astrutz/PPSS18Strutz/Dokumente/Bachelorarbeit/chapter/titelseite.tex

%!TEX root = ../main.tex
\begin{titlepage}

\begin{center}

% Logo der Technische Hochschule Köln
\begin{figure}[!ht]
%	\centering
%		\includegraphics[width=0.26\textwidth]{/images/THlogoheader.pdf}
\end{figure}

\vspace{0.4cm}

%Deutscher Titel
\begin{rmfamily}
\begin{huge}
\textbf{Nutzerzentrierte Entwicklung eines Systems zur Synchronisation von analogen und digitalen Scrumboards}\\	
\end{huge}
\vspace{0.5cm}
%\begin{LARGE}
%ggf. Untertitel\\
%\end{LARGE}
\end{rmfamily}

\vspace{0.8cm}

%Englischer Titel
% \begin{rmfamily}
% \textbf{\LARGE Title in English}\\
% \large with a very\\long subtitle\\
% \normalsize
% \end{rmfamily}

% \vspace{1.2cm}

%Bachelorarbeit 
\begin{LARGE}
\begin{scshape}
Bachelorarbeit\\[0.8em]
\end{scshape}
\end{LARGE}

%ausgearbeitet von...
\begin{large}
ausgearbeitet von\\ 
\vspace{0.3cm}
\begin{LARGE}
Alexander Strutz\\
\end{LARGE}
\end{large}

\vspace{1.2cm}

%zur Erlangung des akademischen Grades...
\begin{large}
zur Erlangung des akademischen Grades\\
\vspace{0.1cm}
\textsc{Bachelor of Science (B.Sc.)}\\ 
\end{large}

\vspace{0.6cm}

%vorgelegt an der...
\begin{large}
vorgelegt an der\\ 
\vspace{0.2cm}
\begin{scshape}
Technischen Hochschule Köln\\
Campus Gummersbach\\
Fakultät für Informatik und\\
Ingenieurwissenschaften\\
\end{scshape}
\end{large}

\vspace{0.6cm}

%im Studiengang...
\begin{large}
im Studiengang\\ 
\vspace{0.1cm}
\textsc{Medieninformatik}
\end{large}

\vspace{1.2cm}

%Autor der Bachelorarbeit und die Prüfer
\begin{tabular}{rl}
        Erster Prüfer:  &  Prof. Dr. Matthias Böhmer\\
       					&  \small Technische Hochschule Köln \\[1.0em]
       Zweiter Prüfer:  &  Oliver Blum\\
       					&  \small kernpunkt Digital GmbH\\
\end{tabular}

\vspace{1.2cm}

%Ort, Monat der Abgabe
\begin{large}
Gummersbach, im Dezember \the\year
\end{large}

\end{center}

\newpage
\thispagestyle{empty}

%Kontaktmöglichkeiten des Autors und der Prüfer
\begin{center}
\begin{tabular}{rl}
							&  \\[26.0em]
							
\large \textbf{Adressen:}	&  	\quad Alexander Gabriel Strutz\\
							&  	\quad Hohe Straße 28\\
							&	\quad 51643 Gummersbach\\
							&  	\quad astrutz@th-koeln.de\\[2.0em]
							
							&  	\quad Prof. Dr. Matthias Böhmer\\
							&  	\quad Technische Hochschule Köln\\
							&  	\quad Institut für Informatik\\
							&	\quad Steinmüllerallee 1\\
							&	\quad 51643 Gummersbach\\
							&  	\quad matthias.boehmer@th-koeln.de\\[2.0em]
							
							&  	\quad Oliver Blum\\
							&  	\quad kernpunkt Digital GmbH\\
							&	\quad Oskar-Jäger-Straße 173\\
							&	\quad 50825 Köln\\
							&  	\quad oliver.blum@kernpunkt.de\\[2.0em]
\end{tabular}
\end{center}

\end{titlepage}
