astrutz/PPSS18Strutz/Dokumente/Bachelorarbeit/chapter/eid.tex

%!TEX root = ../main.tex
\chapter*{Eidesstattliche Erklärung}

Ich versichere, die von mir vorgelegte Arbeit selbständig verfasst zu haben.\\ \\
Alle Stellen, die wörtlich oder sinngemäß aus veröffentlichten oder nicht veröffentlichten Arbeiten anderer entnommen sind, habe ich als entnommen kenntlich gemacht. Sämtliche Quellen und Hilfsmittel, die ich für die Arbeit benutzt habe, sind angegeben.\\ \\
Die Arbeit hat mit gleichem Inhalt bzw. in wesentlichen Teilen noch keiner anderen Prüfungsbehörde vorgelegen.
\vspace{1.5cm}
\\
Gummersbach, \today
\vspace{3cm}
\\
Alexander Gabriel Strutz
