astrutz/PPSS18Strutz/Dokumente/Bachelorarbeit/chapter/header.tex

%!TEX root = ../main.tex
%\documentclass[12pt]{article}
\documentclass[BCOR=12mm,DIV=11,titlepage,a4paper,oneside]{scrbook}
\usepackage{scrhack}
\usepackage[ngerman]{babel}
\usepackage[utf8x]{inputenc}
\usepackage{amsmath}
\usepackage{graphicx}
\usepackage{caption}
\usepackage[colorinlistoftodos]{todonotes}
\usepackage{subcaption}

%fancyheadings funktioniert nicht mehr mit der KOMA Script Klasse scrbook

\usepackage{wrapfig}

\usepackage{cite}

% Mittels [H] können Bilder genau an einer Stelle positioniert werden
\usepackage{float}

\usepackage[breaklinks]{hyperref}

% bewirkt das HyperLinks in der PDF nicht umrandet oder farbig sind
\hypersetup{colorlinks=false}

% package for colored text
% black,white,green,red,blue,yellow,cyan,magenta
\usepackage{color}

% package for colored tables
\usepackage{colortbl}

%Paket zur Erzeugung von Anführungszeichen durch \enquote{Text}
\usepackage[ngerman]{babel}
\usepackage[babel, german=quotes]{csquotes}

%Verhindern, dass eine neue Seite für ein einzelnes Wort/Zeile verwendet wird
\clubpenalty = 10000 % schliesst Schusterjungen aus 
\widowpenalty = 10000 % schliesst Hurenkinder aus (keine Beleidigung, sondern wirklich ein Fachbegriff)

\usepackage{lipsum}

\pagenumbering{gobble}
