astrutz/PPSS18Strutz/Dokumente/Bachelorarbeit/chapter/00_abstract.tex

%!TEX root = ../main.tex
\chapter*{Abstract}
\label{cha:Einleitung}
Hier folgt die Kurzfassung auf Englisch. Wenn Sie diese Vorlage für Seminararbeiten, Projektdokumentation o.ä. verwenden ist eine englische Kurzfassung ggf. nicht nötig.
