astrutz/PPSS18Strutz/Dokumente/Bachelorarbeit/chapter/03_durchfuehrung_und_vorgehensweise.tex

%!TEX root = ../main.tex
\chapter{Durchführung und Vorgehensweise}
\label{cha:durchfuehrung_und_vorgehensweise}

\section{Abweichungen vom menschzentrierten Entwicklungsprozess}
\label{sec:abweichungen_menschzentriert}
Fußnoten können zum Teil sehr nützlich sein. Bitte beachten Sie, dass bei übermäßiger Verwendung von Fußnoten, die Lesbarkeit einschränkt sein.

\section{Festlegung der Anzahl an Teams und Phasen}
\label{sub:festlegung_anzahl_teams_phase}
Sie können in Latex viel machen.

\section{Formulierung einer Forschungsfrage}
\label{sub:formulierung_forschungsfrage}
Sie können in Latex viel machen.
