astrutz/PPSS18Strutz/Dokumente/Bachelorarbeit/chapter/04_erster_entwicklungszyklus.tex

%!TEX root = ../main.tex
\chapter{Erster Entwicklungszyklus}
\label{cha:erster_entwicklungszyklus}

\section{Testen des Systems und Befragungen verschiedener Teams} 
\label{sec:erster_testen_befragen}
Fußnoten können zum Teil sehr nützlich sein. 

\section{Definition von Anforderungen als User Stories anhand der Ergebnisse der Befragungen} 
\label{sec:erster_anforderungen_user_stories}
Fußnoten können zum Teil sehr nützlich sein. 

\section{Implementation der Anforderungen} 
\label{sec:erster_implementation}
Fußnoten können zum Teil sehr nützlich sein.
