astrutz/PPSS18Strutz/Dokumente/Bachelorarbeit/chapter/05_zweiter_entwicklungszyklus.tex

%!TEX root = ../main.tex
\chapter{Zweiter Entwicklungszyklus}
\label{cha:zweiter_entwicklungszyklus}

\section{Testen des Systems und Befragungen verschiedener Teams} 
\label{sec:zweiter_testen_befragen}
Fußnoten können zum Teil sehr nützlich sein. 

\section{Definition von Anforderungen als User Stories anhand der Ergebnisse der Befragungen} 
\label{sec:zweiter_anforderungen_user_stories}
Fußnoten können zum Teil sehr nützlich sein. 

\section{Implementation der Anforderungen} 
\label{sec:zweiter_implementation}
Fußnoten können zum Teil sehr nützlich sein.
