astrutz/PPSS18Strutz/Dokumente/Bachelorarbeit/chapter/06_dritter_entwicklungszyklus.tex

%!TEX root = ../main.tex
\chapter{Dritter Entwicklungszyklus}
\label{cha:dritter_entwicklungszyklus}

\section{Testen des Systems und Befragungen verschiedener Teams} 
\label{sec:dritter_testen_befragen}
Fußnoten können zum Teil sehr nützlich sein. 

\section{Definition von Anforderungen als User Stories anhand der Ergebnisse der Befragungen} 
\label{sec:dritter_anforderungen_user_stories}
Fußnoten können zum Teil sehr nützlich sein. 

\section{Implementation der Anforderungen} 
\label{sec:dritter_implementation}
Fußnoten können zum Teil sehr nützlich sein.
