astrutz/PPSS18Strutz/Dokumente/Bachelorarbeit/chapter/08_fazit.tex

%!TEX root = ../main.tex
\chapter{Fazit}
\label{cha:fazit}

\section{Vergleich des Systems mit dem anfänglichen Prototyp} 
\label{sec:vergleich_system_prototyp}
Fußnoten können zum Teil sehr nützlich sein. 

\section{Bewertung der angewandten Methodik und der Vorgehensweise} 
\label{sec:bewertung_methodik_vorgehensweise}
Fußnoten können zum Teil sehr nützlich sein. 

\section{Beantwortung der Forschungsfrage} 
\label{sec:beantwortung_forschungsfrage}
Fußnoten können zum Teil sehr nützlich sein.
