astrutz/PPSS18Strutz/Dokumente/Bachelorarbeit/chapter/09_ausblick.tex

%!TEX root = ../main.tex
\chapter{Ausblick und nötige Schritte hin zu einer Produktion}
\label{cha:ausblick}
