astrutz/PPSS18Strutz/Dokumente/Praxisprojekt/serverSetStatus.PNG

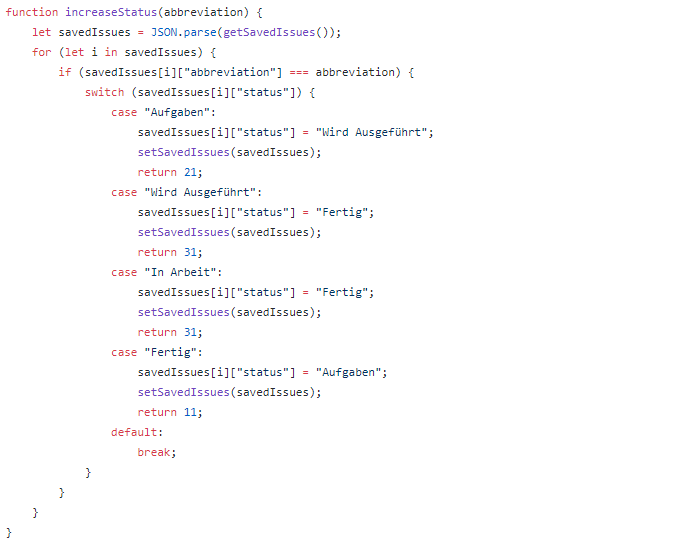
Dokumente/Praxisprojekt/serverSetStatus.PNG
