astrutz/PPSS18Strutz/Dokumente/Praxisprojekt/terminalHelper.PNG

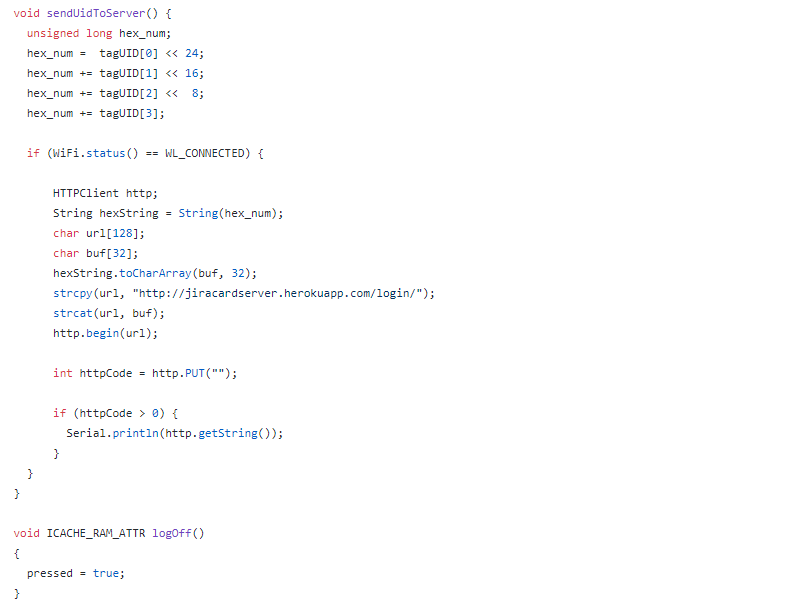
Dokumente/Praxisprojekt/terminalHelper.PNG
