astrutz/PPSS18Strutz/Dokumente/Praxisprojekt/terminalLoop.PNG

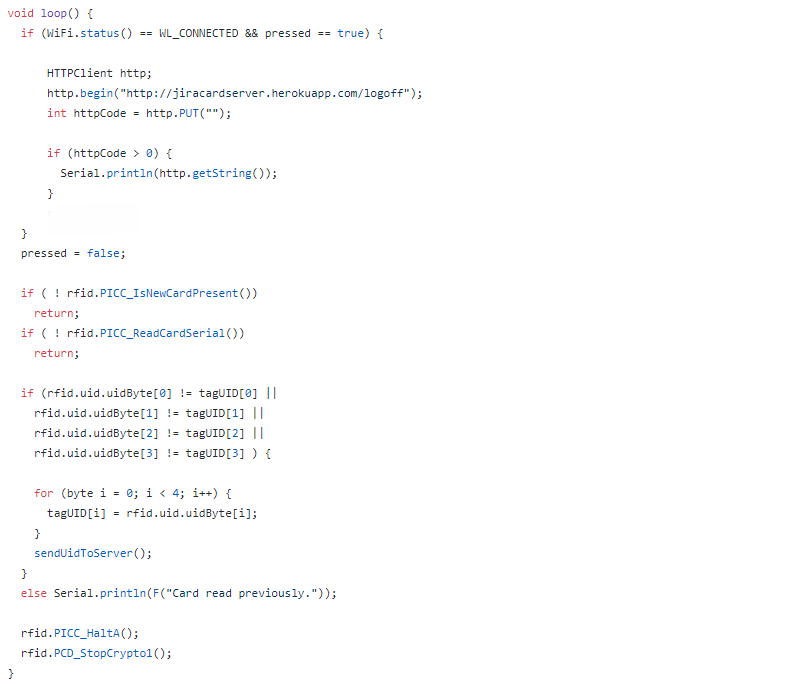
Dokumente/Praxisprojekt/terminalLoop.PNG
