astrutz/PPSS18Strutz/Dokumente/Praxisprojekt/Materialliste.txt

revolt PX-4945-675 Akku
NodeMCU Lua Lolin V3
RFID RC522 Set
Raspberry Pi Zero
Sonstige Kabel
