astrutz/PPSS18Strutz/Dokumente/Bachelorarbeit/Epic Stantia (3).stl

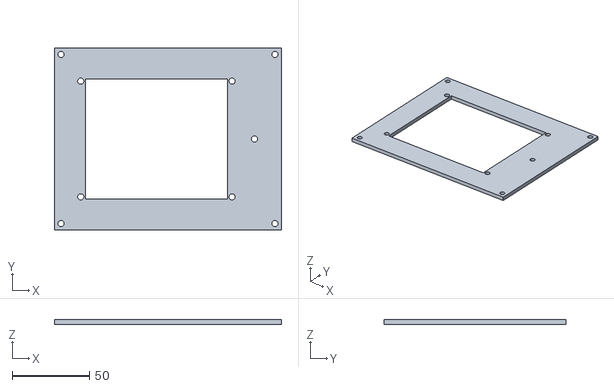
[picture p35: CAD file, 2019-11-13]
Dokumente/Bachelorarbeit/Epic Stantia (3).stl
147.0 x 118.0 x 3.00
