astrutz/PPSS18Strutz/Dokumente/Bachelorarbeit/Epic Stantia (2).stl

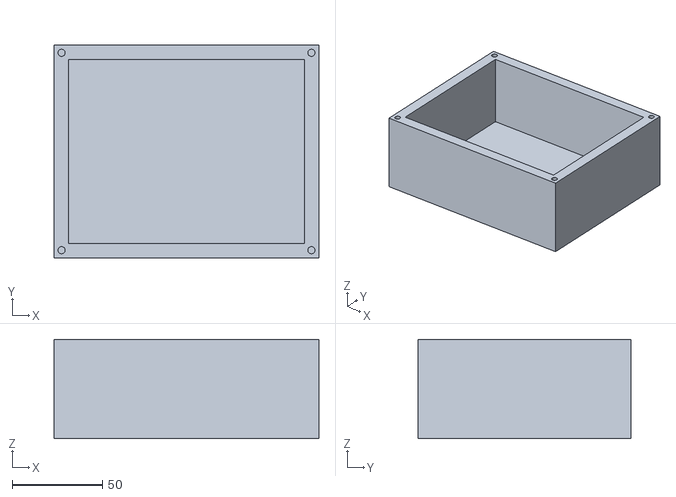
[picture p36: CAD file, 2019-11-13]
Dokumente/Bachelorarbeit/Epic Stantia (2).stl
147.0 x 118.0 x 55.0
