astrutz/PPSS18Strutz/Dokumente/Bachelorarbeit/chapter/07_abschliessende_evaluation.tex

%!TEX root = ../main.tex
\chapter{Abschließende Evaluation durch Befragung der Scrum-Teams}
\label{cha:abschliessende_evaluation}
