astrutz/PPSS18Strutz/(commit log)

2019-02-01 [PLAN] Empty months
    [Projektplan.xlsx]
2019-02-07 [PLAN] Working days
    [Projektplan.xlsx]
2019-02-14 [DOC] materials from oblum
2019-02-15 [PLAN] seperate project and private planning
    [Projektplan.xlsx, Zeitplan.xlsx]
2019-02-19 [DOC] manuals for test prototype
2019-02-19 [DOC] Replacing the right arduino manual
2019-03-29 [PROTO] Example in arduino ide
2019-05-03 [PROTO] Button listener
2019-05-03 [PROTO] Contact API when button is pressed
2019-05-03 [PROTO] Pinouts for button
2019-05-17 [PROTO] Change status with button
2019-05-17 [PROTO] Implement different button actions for logged in and not logged in
2019-05-17 [PROTO] Looking up for press button
2019-06-07 [PROTO] Fixing button problems
    [Story.ino, Terminal.ino]
2019-06-07 [PROTO] Moving sketches to be detected by Arduino IDE
2019-06-07 [PROTO] Built a working terminal with logoff button
2019-06-16 [DOC] SPI Introduction
2019-06-30 [PROTO] Fix Card Restart with IRAM
    [Story.ino, Terminal.ino]
2019-07-08 [DOC] Prepare appendix for physical board
2019-11-13 [THESIS] Modelling the chassis
    [Epic Stantia (2).stl, Epic Stantia (3).stl]
